friscv/friscv-system-hw/rtl/core/friscv_mem_stage.sv

// Copyright 2026 FER, HPC Architecture and Application Research Center
// SPDX-License-Identifier: Apache-2.0 WITH SHL-2.1
//
// Licensed under the Solderpad Hardware License v 2.1 (the "License");
// you may not use this file except in compliance with the License, or,
// at your option, the Apache License version 2.0.
// You may obtain a copy of the License at https://solderpad.org/licenses/SHL-2.1/
//
// Version info is listed in friscv_pkg.sv

/*
 * This module implements the memory stage of the FRISC-V pipeline.
 * It handles memory accesses, load data capture and expansion, LR/SC operations, and page fault handling.
 */

`timescale 1ns / 1ps

import friscv_pkg::*;

module friscv_mem_stage (
    input  logic           clk_in,
    input  logic           rst_n_in,

    // Stage control signals
    input  logic           stage_stall_in,
    input  logic           trap_commit_in,
    input  logic           addr_virtual_in,

    // Inputs from EX stage
    input  addr_t          pc_in,
    input  addr_t          pc_plus_4_in,
    input  data_t          alu_data_in,
    input  reg_addr_t      rd_sel_in,
    input  data_t          store_data_in,
    input  mem_instr_sel_e mem_instr_sel_in,
	input  mem_width_e     load_store_width_in,
	input  wb_data_sel_e   wb_data_sel_in,
    input  csr_addr_e      csr_sel_in,
    input  data_t          csr_readback_in,
    input  logic           csr_en_in,
    input  logic           instr_valid_in,
    input  mode_e          mode_in,

    // AMO control
    input  logic           reserve_in,
    input  logic           conditional_in,
    input  logic           clear_reserve_in,
    input  amo_op_e        amo_op_in,

    // Outputs to WB stage
    output addr_t          pc_plus_4_out,
    output data_t          alu_data_out,
    output data_t          load_data_out,
    output data_t          sc_res_out,
    output wb_data_sel_e   wb_data_sel_out,
    output reg_addr_t      rd_sel_out,
    output csr_addr_e      csr_sel_out,
    output data_t          csr_data_out,
    output data_t          csr_readback_out,
    output logic           csr_en_out,
    output logic           instr_valid_out,

    // Page fault inputs from MMU
    input  logic           load_fault_in,
    input  logic           store_fault_in,
    input  addr_t          fault_addr_in,

    // Page fault output to ID stage
    output mem_trap_e      mem_trap_out,
    output addr_t          mem_trap_pc_out,
    output addr_t          mem_trap_va_out,
    output mode_e          mem_trap_mode_out,

    // Data memory interface
    output addr_t          d_mem_addr_out,
    output data_t          d_mem_data_out,
    input  data_t          d_mem_data_in,
    output logic           d_mem_en_out,
    output logic           d_mem_wr_out,
    output logic           d_mem_store_like_out,
    output mem_width_e     d_mem_size_out,
    input  logic           d_mem_wait_in,
    input  logic           d_mem_err_in,
    output amo_op_e        d_mem_amo_op_out
);

// Input buffers
typedef struct packed {
    addr_t          pc;
    addr_t          pc_plus_4;
    addr_t          alu_data;
    data_t          store_data;
    reg_addr_t      rd_sel;
    mem_instr_sel_e mem_instr_sel;
    mem_width_e     load_store_width;
    wb_data_sel_e   wb_data_sel;
    logic           conditional;
    logic           clear_reserve;
    logic           misaligned;
    amo_op_e        amo_op;
    csr_addr_e      csr_sel;
    data_t          csr_readback;
    logic           csr_en;
    logic           instr_valid;
    mode_e          mode;
} mem_pipe_t;

// A NOP instance of the pipeline register struct (mem_pipe_t)
localparam mem_pipe_t MEM_PIPE_BUBBLE = '{
    pc: '0,
    pc_plus_4: '0,
    alu_data: '0,
    store_data: '0,
    rd_sel: 5'b0,
    mem_instr_sel: MEM_INSTR_NONE,
    load_store_width: WIDTH_I32,
    wb_data_sel: WB_DATA_SEL_ALU,
    conditional: 1'b0,
    clear_reserve: 1'b0,
    misaligned: 1'b0,
    amo_op: AMO_NONE,
    csr_sel: CSR_ZERO,
    csr_readback: '0,
    csr_en: 1'b0,
    instr_valid: 1'b0,
    mode: M_MODE
};

mem_pipe_t pipe_buff;

// Fault capture
// Set when a fault fires on the memory commit cycle
mem_trap_e r_mem_fault;
addr_t     r_mem_fault_pc;
addr_t     r_mem_fault_va;
mode_e     r_mem_fault_mode;

assign mem_trap_out    = r_mem_fault;
assign mem_trap_pc_out = r_mem_fault_pc;
assign mem_trap_va_out = r_mem_fault_va;
assign mem_trap_mode_out = r_mem_fault_mode;

logic w_mem_completion_fault;
assign w_mem_completion_fault = r_mem_active &&
                                !d_mem_wait_in &&
                                (load_fault_in || store_fault_in ||
                                 d_mem_err_in || pipe_buff.misaligned);

// CSR passthrough
assign csr_sel_out      = pipe_buff.csr_sel;
assign csr_data_out     = pipe_buff.alu_data;
assign csr_readback_out = pipe_buff.csr_readback;
assign csr_en_out       = pipe_buff.csr_en && !w_mem_completion_fault;

data_t load_data;
data_t load_data_buff;  // Buffered load data

logic r_mem_active;
logic r_load_data_valid;  // Flag indicating load data has been captured

logic w_is_mem_instr;
assign w_is_mem_instr = mem_instr_sel_in != MEM_INSTR_NONE;

// Detect if this is a store-like instruction (store, SC, or AMO)
logic w_mem_store_like;
assign w_mem_store_like = (mem_instr_sel_in == MEM_INSTR_STORE) || (amo_op_in != AMO_NONE);

logic r_mem_store_like;
assign r_mem_store_like = (pipe_buff.mem_instr_sel == MEM_INSTR_STORE) || (pipe_buff.amo_op != AMO_NONE);

// Detect if this is an atomic-like instruction (LR/SC or AMO)
logic w_mem_atomic_like;
assign w_mem_atomic_like = reserve_in || conditional_in || (amo_op_in != AMO_NONE);

logic r_mem_atomic_like;
assign r_mem_atomic_like = pipe_buff.clear_reserve || pipe_buff.conditional || (pipe_buff.amo_op != AMO_NONE);

logic w_misaligned_access_fault;
assign w_misaligned_access_fault = addr_virtual_in && w_mem_atomic_like;

logic r_misaligned_access_fault;
assign r_misaligned_access_fault = r_mem_atomic_like;

logic w_mem_misaligned;
always_comb begin
    case (load_store_width_in)
        WIDTH_I16, WIDTH_U16: w_mem_misaligned = alu_data_in[0];
        WIDTH_I32:            w_mem_misaligned = alu_data_in[1:0] != 2'b00;
        default:              w_mem_misaligned = 1'b0;
    endcase
end

// Pass valid flag to WB; suppress same-cycle writeback when a memory op faults.
assign instr_valid_out = pipe_buff.instr_valid && !w_mem_completion_fault;

// Reservation register for AMO LR/SC
logic  reserve_valid;
addr_t reserve_addr;
logic  r_sc_res_valid;
logic  r_sc_res;

// Can execute memory instruction if either
//  1) It is a store conditional instruction with a valid reservation for the requested address or
//  2) It is not a store conditional instruction
logic cond_valid;
logic cond_valid_r;
logic prev_sc_success;

assign prev_sc_success = pipe_buff.instr_valid && pipe_buff.conditional && cond_valid_r;
assign cond_valid = (conditional_in) ? reserve_valid && !prev_sc_success && (reserve_addr == alu_data_in) : 1'b1;

// ============================================================
// Input capture
// ============================================================

// MEM stage always accepts data from EX stage
// Bubbles are inserted by EX sending instructions with rd_sel=0
always_ff @(posedge clk_in or negedge rst_n_in) begin
    if (!rst_n_in) begin
        pipe_buff         <= MEM_PIPE_BUBBLE;
        r_mem_active      <= 1'b0;
        r_load_data_valid <= 1'b0;
        load_data_buff    <= '0;
        reserve_valid     <= 1'b0;
        reserve_addr      <= '0;
        r_sc_res_valid    <= 1'b0;
        r_sc_res          <= 1'b0;
        cond_valid_r      <= 1'b0;
        r_mem_fault       <= MEM_TRAP_NONE;
        r_mem_fault_pc    <= '0;
        r_mem_fault_va    <= '0;
        r_mem_fault_mode  <= M_MODE;

    end else begin

        if (clear_reserve_in) begin
            reserve_valid <= 1'b0;
        end

        if (trap_commit_in) begin
            // The fault has been consumed by the trap logic. Keep MEM as a
            // bubble while the earlier pipeline stages redirect to the handler.
            pipe_buff         <= MEM_PIPE_BUBBLE;
            r_mem_active      <= 1'b0;
            r_load_data_valid <= 1'b0;
            r_sc_res_valid    <= 1'b0;
            cond_valid_r      <= 1'b0;
            r_mem_fault       <= MEM_TRAP_NONE;
            reserve_valid     <= 1'b0;
        end else if (r_mem_fault != MEM_TRAP_NONE) begin
            // Hold the oldest captured memory fault until ID commits the trap.
            r_mem_active          <= 1'b0;
            r_load_data_valid     <= 1'b0;
            r_sc_res_valid        <= 1'b0;
            pipe_buff.instr_valid <= 1'b0;
        end else if (!stage_stall_in) begin
            // When an older memory op faults on the same cycle the pipeline
            // would otherwise advance, the younger EX instruction must be
            // ignored completely.
            if (r_mem_active &&
                ((load_fault_in || store_fault_in) ||
                 (!d_mem_wait_in && (d_mem_err_in || pipe_buff.misaligned)))) begin
                pipe_buff         <= MEM_PIPE_BUBBLE;
                r_mem_active      <= 1'b0;
                r_load_data_valid <= 1'b0;
                r_sc_res_valid    <= 1'b0;
                cond_valid_r      <= 1'b0;
                r_mem_fault_pc    <= pipe_buff.pc;
                r_mem_fault_mode  <= pipe_buff.mode;
                if (load_fault_in || store_fault_in) begin
                    r_mem_fault    <= store_fault_in ? MEM_TRAP_STORE : MEM_TRAP_LOAD;
                    r_mem_fault_va <= fault_addr_in;
                end else if (d_mem_err_in) begin
                    r_mem_fault    <= r_mem_store_like ? MEM_TRAP_STORE_ACCESS : MEM_TRAP_LOAD_ACCESS;
                    r_mem_fault_va <= pipe_buff.alu_data;
                end else begin
                    r_mem_fault    <= r_misaligned_access_fault
                                      ? (r_mem_store_like ? MEM_TRAP_STORE_ACCESS : MEM_TRAP_LOAD_ACCESS)
                                      : (r_mem_store_like ? MEM_TRAP_STORE_MISALIGNED : MEM_TRAP_LOAD_MISALIGNED);
                    r_mem_fault_va <= pipe_buff.alu_data;
                end
            end else if (instr_valid_in && w_is_mem_instr && w_mem_misaligned) begin
                // Load/store to misaligned address
                pipe_buff         <= MEM_PIPE_BUBBLE;
                r_mem_active      <= 1'b0;
                r_load_data_valid <= 1'b0;
                r_sc_res_valid    <= 1'b0;
                cond_valid_r      <= 1'b0;
                r_mem_fault       <= w_misaligned_access_fault
                                     ? (w_mem_store_like ? MEM_TRAP_STORE_ACCESS : MEM_TRAP_LOAD_ACCESS)
                                     : (w_mem_store_like ? MEM_TRAP_STORE_MISALIGNED : MEM_TRAP_LOAD_MISALIGNED);
                r_mem_fault_pc    <= pc_in;
                r_mem_fault_va    <= alu_data_in;
                r_mem_fault_mode  <= mode_in;
            end else begin
                // If no faults, capture the new instruction.
                pipe_buff <= '{
                    pc: pc_in,
                    pc_plus_4: pc_plus_4_in,
                    alu_data: alu_data_in,
                    store_data: store_data_in,
                    rd_sel: rd_sel_in,
                    mem_instr_sel: mem_instr_sel_in,
                    load_store_width: load_store_width_in,
                    wb_data_sel: wb_data_sel_in,
                    conditional: conditional_in,
                    clear_reserve: clear_reserve_in,
                    misaligned: w_mem_misaligned,
                    amo_op: amo_op_in,
                    csr_sel: csr_sel_in,
                    csr_readback: csr_readback_in,
                    csr_en: csr_en_in,
                    instr_valid: instr_valid_in,
                    mode: mode_in
                };
                r_mem_active      <= w_is_mem_instr && (cond_valid || (conditional_in && addr_virtual_in));
                r_load_data_valid <= 1'b0;  // Clear on new instruction
                r_sc_res_valid    <= 1'b0;
                cond_valid_r      <= cond_valid;
                r_mem_fault       <= MEM_TRAP_NONE;  // Clear fault on new instruction
            end

            if (!clear_reserve_in &&
                !(instr_valid_in && w_is_mem_instr && w_mem_misaligned)) begin
                if (reserve_in) begin
                    reserve_valid <= 1'b1;
                    reserve_addr  <= alu_data_in;
                end else if (conditional_in && cond_valid) begin
                    // A successful SC.W consumes the active reservation.
                    reserve_valid <= 1'b0;
                end
            end
        end

        else if (r_mem_active && !d_mem_wait_in) begin
            r_mem_active <= 1'b0;

            // Capture page fault
            if (load_fault_in || store_fault_in) begin
                r_mem_fault      <= store_fault_in ? MEM_TRAP_STORE : MEM_TRAP_LOAD;
                r_mem_fault_pc   <= pipe_buff.pc;
                r_mem_fault_va   <= fault_addr_in;
                r_mem_fault_mode <= pipe_buff.mode;
                pipe_buff.rd_sel <= 5'b0;  // Suppress WB writeback for faulting instruction
                pipe_buff.instr_valid <= 1'b0;
            end else if (d_mem_err_in) begin
                // Capture access fault
                r_mem_fault    <= r_mem_store_like ? MEM_TRAP_STORE_ACCESS : MEM_TRAP_LOAD_ACCESS;
                r_mem_fault_pc <= pipe_buff.pc;
                r_mem_fault_va <= pipe_buff.alu_data;
                r_mem_fault_mode <= pipe_buff.mode;
                pipe_buff.rd_sel <= 5'b0;
                pipe_buff.instr_valid <= 1'b0;
            end else if (pipe_buff.misaligned) begin
                r_mem_fault    <= r_misaligned_access_fault
                                  ? (r_mem_store_like ? MEM_TRAP_STORE_ACCESS : MEM_TRAP_LOAD_ACCESS)
                                  : (r_mem_store_like ? MEM_TRAP_STORE_MISALIGNED : MEM_TRAP_LOAD_MISALIGNED);
                r_mem_fault_pc <= pipe_buff.pc;
                r_mem_fault_va <= pipe_buff.alu_data;
                r_mem_fault_mode <= pipe_buff.mode;
                pipe_buff.rd_sel <= 5'b0;
                pipe_buff.instr_valid <= 1'b0;
            end

            // Clear reservation after SC completes
            if (pipe_buff.conditional && !(load_fault_in || store_fault_in || d_mem_err_in || pipe_buff.misaligned)) begin
                reserve_valid <= 1'b0;
                r_sc_res <= !cond_valid_r;
                r_sc_res_valid <= 1'b1;
            end

            // Capture load data when load completes
            // Skip on fault
            if (pipe_buff.mem_instr_sel == MEM_INSTR_LOAD &&
                !(load_fault_in || store_fault_in || d_mem_err_in || pipe_buff.misaligned)) begin
                load_data_buff <= load_data;
                r_load_data_valid <= 1'b1;
            end
        end

    end
end

assign d_mem_en_out   = r_mem_active;
assign d_mem_data_out = pipe_buff.store_data;
assign d_mem_wr_out   = r_mem_active && (pipe_buff.mem_instr_sel == MEM_INSTR_STORE) &&
                        (!pipe_buff.conditional || cond_valid_r);
assign d_mem_store_like_out = r_mem_active && r_mem_store_like;
assign d_mem_amo_op_out     = r_mem_active ? pipe_buff.amo_op : AMO_NONE;

// ============================================================
// Address and width enum conversion alignment
// ============================================================

always_comb begin
    if (d_mem_en_out) begin
        // The downstream memory system expects WIDTH_I8/16/32, so convert U encodings into I.
        case (pipe_buff.load_store_width)
            WIDTH_U8:  d_mem_size_out = WIDTH_I8;
            WIDTH_U16: d_mem_size_out = WIDTH_I16;
            default:   d_mem_size_out = pipe_buff.load_store_width;
        endcase
        // Clear low bits for misaligned accesses, which will trap anyway,
        // but ensures the memory system never sees an unexpected address.
        case (pipe_buff.load_store_width)
            WIDTH_I8, WIDTH_U8:   d_mem_addr_out = pipe_buff.alu_data;
            WIDTH_I16, WIDTH_U16: d_mem_addr_out = {pipe_buff.alu_data[ADDR_WIDTH-1:1], 1'b0};
            WIDTH_I32:            d_mem_addr_out = {pipe_buff.alu_data[ADDR_WIDTH-1:2], 2'b00};
            default:              d_mem_addr_out = pipe_buff.alu_data;
        endcase
    end else begin
        d_mem_size_out = WIDTH_I32;
        d_mem_addr_out = '0;
    end
end

// ============================================================
// Load data expansion to 32b
// ============================================================

// Data will be byte-aligned by how it is stored in memory, so we must shift it to the
// right position based on the original address and the access width.
// ie. for a LH reading 0x1234xxxx from address 0x1002, the data will be stored as 0x00001234 in a register.

always_comb begin
    case (pipe_buff.load_store_width)
        WIDTH_I8: begin
            case (pipe_buff.alu_data[1:0])
                2'b00: load_data = {{24{d_mem_data_in[ 7]}}, d_mem_data_in[ 7: 0]};
                2'b01: load_data = {{24{d_mem_data_in[15]}}, d_mem_data_in[15: 8]};
                2'b10: load_data = {{24{d_mem_data_in[23]}}, d_mem_data_in[23:16]};
                2'b11: load_data = {{24{d_mem_data_in[31]}}, d_mem_data_in[31:24]};
            endcase
        end
        WIDTH_U8: begin
            case (pipe_buff.alu_data[1:0])
                2'b00: load_data = {24'h0, d_mem_data_in[ 7: 0]};
                2'b01: load_data = {24'h0, d_mem_data_in[15: 8]};
                2'b10: load_data = {24'h0, d_mem_data_in[23:16]};
                2'b11: load_data = {24'h0, d_mem_data_in[31:24]};
            endcase
        end
        WIDTH_I16: begin
            if (pipe_buff.alu_data[1])
                load_data = {{16{d_mem_data_in[31]}}, d_mem_data_in[31:16]};
            else
                load_data = {{16{d_mem_data_in[15]}}, d_mem_data_in[15:0]};
        end
        WIDTH_U16: begin
            if (pipe_buff.alu_data[1])
                load_data = {16'h0, d_mem_data_in[31:16]};
            else
                load_data = {16'h0, d_mem_data_in[15:0]};
        end
        default: begin
            load_data = d_mem_data_in;
        end
    endcase
end

// ============================================================
// Forward to WB
// ============================================================

assign load_data_out = r_load_data_valid ? load_data_buff : load_data;
assign sc_res_out    = {31'h0, r_sc_res_valid ? r_sc_res : !cond_valid_r};

assign rd_sel_out       = w_mem_completion_fault ? 5'b0 : pipe_buff.rd_sel;
assign pc_plus_4_out    = pipe_buff.pc_plus_4;
assign alu_data_out     = pipe_buff.alu_data;
assign wb_data_sel_out  = pipe_buff.wb_data_sel;

endmodule
