friscv/friscv-system-hw/scripts/gen_zsbl_rom.py

#!/usr/bin/env python3
import sys
import subprocess
import re
import argparse
from pathlib import Path


def assemble_and_link(input_file, output_elf, linker_script=None, simulation=False):
    """Assemble and link RISC-V assembly to ELF."""
    # First assemble
    temp_obj = input_file.with_suffix('.o')
    cmd_as = [
        "riscv64-unknown-elf-as",
        "-march=rv32i",
        "-mabi=ilp32",
        "-o", str(temp_obj),
    ]
    if simulation:
        cmd_as.append("--defsym")
        cmd_as.append("SIMULATION=1")
    cmd_as.append(str(input_file))
    try:
        subprocess.run(cmd_as, check=True, capture_output=True)
    except subprocess.CalledProcessError as e:
        print(f"ERROR: Assembly failed: {e.stderr.decode()}", file=sys.stderr)
        sys.exit(1)

    # Then link
    cmd_ld = [
        "riscv64-unknown-elf-ld",
        "-m", "elf32lriscv",
        "-o", str(output_elf),
    ]
    if linker_script:
        cmd_ld.extend(["-T", str(linker_script)])
    cmd_ld.append(str(temp_obj))

    try:
        subprocess.run(cmd_ld, check=True, capture_output=True)
    except subprocess.CalledProcessError as e:
        print(f"ERROR: Linking failed: {e.stderr.decode()}", file=sys.stderr)
        sys.exit(1)
    finally:
        # Clean up object file
        temp_obj.unlink(missing_ok=True)


def extract_raw_bytes(elf_file):
    """Extract raw .text section bytes using objcopy."""
    tmp_bin = elf_file.with_suffix('.bin')
    cmd = [
        "riscv64-unknown-elf-objcopy",
        "-O", "binary",
        "--only-section=.text",
        str(elf_file),
        str(tmp_bin),
    ]
    try:
        subprocess.run(cmd, check=True, capture_output=True)
        with open(tmp_bin, 'rb') as f:
            data = f.read()
        return data
    except subprocess.CalledProcessError as e:
        print(f"ERROR: objcopy failed: {e.stderr.decode()}", file=sys.stderr)
        sys.exit(1)
    finally:
        tmp_bin.unlink(missing_ok=True)


def extract_mnemonics(elf_file):
    """Extract address→mnemonic map from objdump for use as comments."""
    cmd = [
        "riscv64-unknown-elf-objdump",
        "-d",
        "-M", "no-aliases,numeric",
        str(elf_file)
    ]
    try:
        result = subprocess.run(cmd, check=True, capture_output=True, text=True)
    except subprocess.CalledProcessError as e:
        print(f"ERROR: Objdump failed: {e.stderr}", file=sys.stderr)
        sys.exit(1)

    mnemonics = {}
    pattern = r"^\s*([0-9a-f]+):\s+[0-9a-f]+\s+(.+)"
    for line in result.stdout.split('\n'):
        match = re.match(pattern, line)
        if match:
            addr = int(match.group(1), 16)
            mnemonics[addr] = match.group(2).strip()
    return mnemonics


def generate_verilog_rom(raw_bytes, mnemonics, output_file, start_addr=0x1000):
    """Generate Verilog ROM module from raw bytes with objdump mnemonics as comments."""

    verilog_template = '''// (c) FER, HPC Architecture and Application Research Center, All rights reserved
// License and version info is listed in friscv_pkg.sv

// AUTO-GENERATED FROM: {input_file}

/*
 * This module implements the boot ROM for the Zero Stage Boot Loader (ZSBL) of the FRISC-V reference design.
 * It is an auto-generated file placed at the reset vector (RESET_VEC=ZSBL_BASE) if ZSBL is enabled (ZSBL_ROM_SIZE_BYTES > 0).
 */

`timescale 1ns / 1ps

import friscv_pkg::*;

module friscv_zsbl_rom (
    input  logic  i_clk,
    input  addr_t i_addr,
    output inst_t o_data
);

(* ram_style = "block" *) inst_t mem [ZSBL_ROM_SIZE_BYTES/4];
localparam int unsigned ZSBL_PROG_WORDS = {num_words};

logic [31:0] w_word_offset;
logic        w_valid;
inst_t       r_data;

assign w_word_offset = (i_addr - RESET_VEC) >> 2;
assign w_valid = (i_addr >= RESET_VEC && w_word_offset < (ZSBL_ROM_SIZE_BYTES/4));

// Registered read for BRAM inference
always_ff @(posedge i_clk) begin
    // Do not reset r_data, will not synthesize as BRAM if reset added
    if (w_valid) begin
        r_data <= mem[w_word_offset];
    end else begin
        r_data <= NOP;
    end
end

assign o_data = r_data;

initial begin
    // Auto-generated program at RESET_VEC ({start_addr})
{instructions}

    for (int i = ZSBL_PROG_WORDS; i < (ZSBL_ROM_SIZE_BYTES/4); i++) begin
        mem[i] = 32\'h0000_0000;
    end
end

endmodule
'''

    # Pad to word boundary
    padded = raw_bytes + b'\x00' * ((-len(raw_bytes)) % 4)
    num_words = len(padded) // 4

    instr_lines = []
    for i in range(num_words):
        word_bytes = padded[i*4 : i*4+4]
        word_val = int.from_bytes(word_bytes, 'little')
        addr = start_addr + i * 4
        mnemonic = mnemonics.get(addr, "")
        hex_str = f"{word_val:08x}"
        formatted = f"h{hex_str[0:4]}_{hex_str[4:8]}"
        instr_lines.append(f"    mem[{i}] = 32'{formatted};  // {mnemonic}")

    instr_block = "\n".join(instr_lines)

    verilog = verilog_template.format(
        input_file=Path(sys.argv[1]).name,
        num_words=num_words,
        start_addr=hex(start_addr),
        instructions=instr_block
    )

    with open(output_file, 'w') as f:
        f.write(verilog)

def main():
    parser = argparse.ArgumentParser(
        description="Generate ZSBL ROM Verilog from RISC-V assembly"
    )
    parser.add_argument("input_file", help="Input .S assembly file")
    parser.add_argument("output_file", help="Output .sv Verilog file")
    parser.add_argument(
        "--linker-script",
        help="Linker script to use (optional)"
    )
    parser.add_argument(
        "--start-addr",
        type=lambda x: int(x, 0),
        default=0x1000,
        help="Start address (default: 0x1000)"
    )
    parser.add_argument(
        "--sim",
        action="store_true",
        default=False,
        help="Build for simulation (defines SIMULATION, sets smaller stack)"
    )

    args = parser.parse_args()

    input_file = Path(args.input_file)
    output_file = Path(args.output_file)

    if not input_file.exists():
        print(f"ERROR: Input file not found: {input_file}", file=sys.stderr)
        sys.exit(1)

    linker_script = None
    if args.linker_script:
        linker_script = Path(args.linker_script)
        if not linker_script.exists():
            print(f"ERROR: Linker script not found: {linker_script}", file=sys.stderr)
            sys.exit(1)

    # Create temporary ELF file
    temp_elf = input_file.with_suffix('.elf')

    print(f"Assembling and linking {input_file}...", file=sys.stderr)
    assemble_and_link(input_file, temp_elf, linker_script, simulation=args.sim)

    print(f"Extracting raw bytes...", file=sys.stderr)
    raw_bytes = extract_raw_bytes(temp_elf)

    print(f"Extracting mnemonics...", file=sys.stderr)
    mnemonics = extract_mnemonics(temp_elf)

    print(f"{len(raw_bytes)} bytes ({len(raw_bytes)//4} words)", file=sys.stderr)
    print(f"Generating {output_file}...", file=sys.stderr)
    generate_verilog_rom(raw_bytes, mnemonics, output_file, args.start_addr)

    # Clean up temporary file
    temp_elf.unlink()

    print(f"Success! Generated {output_file}", file=sys.stderr)


if __name__ == "__main__":
    main()
