friscv/friscv-system-hw/(commit log)

2025-12-10 sim and software
    - new simulation of system_top
    - end signal based on write to specified address
    - zero-stage bootloader at 0x1000 to jump to 0x80000000
    - test asm program
    - python driver and debug notebook
2025-12-10 jump timing fixes
    - simplified jumps by not resetting ex and mem - they just forward a nop generated by id in reset
    [friscv_ex_stage.sv, friscv_id_stage.sv, friscv_mem_stage.sv]
2025-12-13 handling memory stalls
2025-12-26 fixed reset timing error during jumps
    [friscv_id_stage.sv]
2025-12-27 fixed instruction duplication bug
    [friscv_ex_stage.sv]
2025-12-30 memory width fix, build
    [friscv_mem_stage.sv]
2025-12-31 load store width fix and tests
    [tb_cc.sv]
2026-01-02 optimized hazards, mem fix, remove unused signals
    [friscv_core.sv, friscv_mem_stage.sv]
2026-01-09 powershell script, arbiter refactor
2026-01-10 fixed powershell script, cross platform build, readme
2026-01-12 assemble any .S from make
2026-01-16 async reset and styling
    [friscv_core.sv, friscv_ex_stage.sv, friscv_ex_stage_branch_unit.sv, friscv_id_stage.sv, friscv_mem_stage.sv]
2026-01-17 board file, stable ps7_init
2026-02-04 moved uart to rpi header
2026-02-06 switched to 460800 baud
2026-02-12 fixed accidentally broken branch unit
    [friscv_ex_stage_branch_unit.sv, tb_cc.sv]
2026-02-20 mem stage amo update
2026-02-20 fix core signal connections
    [friscv_core.sv]
2026-02-28 Interrupts not working properly
    [friscv_core.sv, friscv_core_complex.sv, friscv_ex_stage.sv, friscv_id_stage.sv, friscv_pkg.sv, tb_cc.sv]
2026-03-01 fixed return from interrupt in sim
    UNSTABLE
    + enum refactor
    + test_irq
    + test_Zalrsc_irq
    [build.py, friscv_core.sv, friscv_core_complex.sv, friscv_ex_stage.sv, friscv_ex_stage_branch_unit.sv, friscv_id_stage.sv, friscv_mem_stage.sv, friscv_pkg.sv]
2026-03-01 interrupts STABLE
    + stable bitstream
    + integration tests
2026-03-09 clint per spec, csrs, core interrupt interface
2026-03-10 remap clint, sync reset, external debounce
    [debounce.v, friscv_core_complex.sv, friscv_cpu_subsystem.sv, friscv_ex_stage.sv, friscv_id_stage.sv, friscv_pkg.sv]
2026-03-11 replaced uartlite with uart 16550
    [tb_cc.sv, tb_integration.sv]
2026-03-12 uart 16550 docs
2026-03-14 mret inhibit fix + bitstream
    [friscv_id_stage.sv]
2026-03-14 timer_irq tests wfi
2026-03-14 delegation test, priority fix
    [friscv_id_stage.sv]
2026-03-14 added device tree
2026-03-14 device tree makefile
2026-03-26 fixed arbiter stall, nop ptw
    [friscv_mmu.sv, friscv_ptw.sv, friscv_tlb.sv]
2026-04-08 load store fault capture fix
    [friscv_mem_stage.sv, friscv_ptw.sv]
2026-04-11 remapped uart
2026-04-11 fixed dts and archstring
    [friscv_id_stage.sv]
2026-04-28 fixed sc, ctr, comb loop
    [friscv_core.sv, friscv_id_stage.sv, friscv_mem_stage.sv]
2026-04-28 detect misaligned target in id
    [friscv_id_stage.sv]
2026-04-30 wired err signal
2026-04-30 fixed the rest of the tests
    [friscv_core.sv, friscv_ex_stage.sv, friscv_id_stage.sv, friscv_mem_stage.sv, friscv_mmu.sv, test.py]
2026-05-06 fixed os boot + bitstream
    [friscv_clint.v, friscv_id_stage.sv, friscv_mem_stage.sv, friscv_pkg.sv, tb_integration.sv]
2026-05-06 Temporarily revert "Added the M instructions"
    This reverts commit d2e1b1cfac40b0def7fe9adbf27395290771876c.
    [friscv_ex_stage.sv, friscv_id_stage.sv, friscv_pkg.sv]
2026-05-12 device tree update
2026-06-01 fix access fault detection
    [friscv_mem_stage.sv]
2026-06-01 fix halt on ebreak system
    [friscv_core.sv, friscv_core_complex.sv]
2026-06-01 Add RGB LED GPIO on Baseboard (AR0-AR2, 0x40020000)
2026-06-01 start terminal after release reset in go target
    [build.py, xmodem_load.py]
2026-06-10 fixed implicit static issue, no ignore verilator errors
    [friscv_id_stage.sv, tb_integration.sv]
2026-06-12 applied solderpad license
